indexdb/WIFI-Temperature-Humidity-Sensor/pcb/BOM_ESP8266 温湿度传感器_超低功耗_PCB2_1_2025-12-18.xlsx

No. | Quantity | Comment | Designator | Footprint | Value | Manufacturer Part | Manufacturer | Supplier Part | Supplier
1 | 1 | BH-18650-B1BA002 | BT1 | BATTERY-SMD_18650-1S-L77.1-W20.7-1 |  | BH-18650-B1BA002 | MYOUNG(美阳) | C2988620 | LCSC
2 | 1 | 10uF | C1 | C0805 |  | C0805X105K101T | HEC | C105952 | LCSC
3 | 1 | 1uF | C2 | C0805 |  | C0805X105K101T | HEC | C105952 | LCSC
4 | 1 | 0.1uf | C5 | C0805 | 4.7nF | TCC0805X7R472K501FT | CCTC(三环) | C282767 | LCSC
5 | 1 | 10uf | C6 | C0805 | 10uf
6 | 1 | 2.4GHz | MK1 | WIRELM-SMD_22P-L24.0-W16.0-P2.00_WT32C3-S5 | 2.4GHz | ESP-12F | DOIT(四博智联) | C19949064 | LCSC
7 | 1 | AO3401 | Q1 | SOT-23-3_L2.9-W1.4-P1.90-LS2.6-BR |  | AO3401 | TWGMC(台湾迪嘉) | C727156 | LCSC
8 | 5 | 10K | R1,R4,R5,R7,R8 | R0805 |  | MCR10EZPF1000 | ROHM Semicon | C162019 | LCSC
9 | 1 | 30K | R3 | R0805 | 30K
10 | 1 | 2kΩ | R6 | R0805 | 2kΩ | 0805W8F2001T5E | UNI-ROYAL(厚声) | C17604 | LCSC
11 | 1 | 10K | R9 | R0805 | 10K
12 | 2 | 10kΩ | R10,R11 | R0805 |  | AECR0603F10K0K9 | ResistorToday | C328335 | LCSC
13 | 1 | 1K | R12 | R0805 |  | SCR0805J1K | VO(翔胜) | C3017842 | LCSC
14 | 1 | 54.9K | R13 | R0805 | 54.9K
15 | 1 | 196.0K | R14 | R0805 | 196.0K
16 | 3 | 100K | R16,R17,R18 | R0805 | 100K
17 | 1 | SIP4-CON4排针 | S1 | HDR-TH_4P-P2.54-V-M-3 |  | SIP4-CON4排针 |  | C9900002129 | LCSC
18 | 1 | TSA343G00-250J2 | SW1 | SW-SMD_L4.0-W2.9-LS5.0 |  | TSA343G00-250J2 | BRIGHT(博瑞泰) | C354946 | LCSC
19 | 1 | HDC2080 | U1 | WSON-6_L3.0-W3.0-P1.00-TL-EP |  | HDC2080DMBR | TI(德州仪器) | C918141 | LCSC
20 | 1 | IP3012A | U2 | SOT-23-5_L3.0-W1.7-P0.95-LS2.8-BL |  | IP3012A | INJOINIC(英集芯) | C605435 | LCSC
21 | 1 | HT-7333-2 | U3 | SOT-89-3_L4.5-W2.5-P1.50-LS4.2-BR |  | HT-7333-2 |  | C9900012669 | LCSC
22 | 1 | TPL5110DDCR | U4 | TSOT-23-6_L2.9-W1.6-P0.95-LS2.8-BR |  | TPL5110DDCR | TI(德州仪器) | C2651358 | LCSC
