indexdb/WIFI-Temperature-Humidity-Sensor/pcb/SCH_Schematic2_1_2025-12-18.pdf

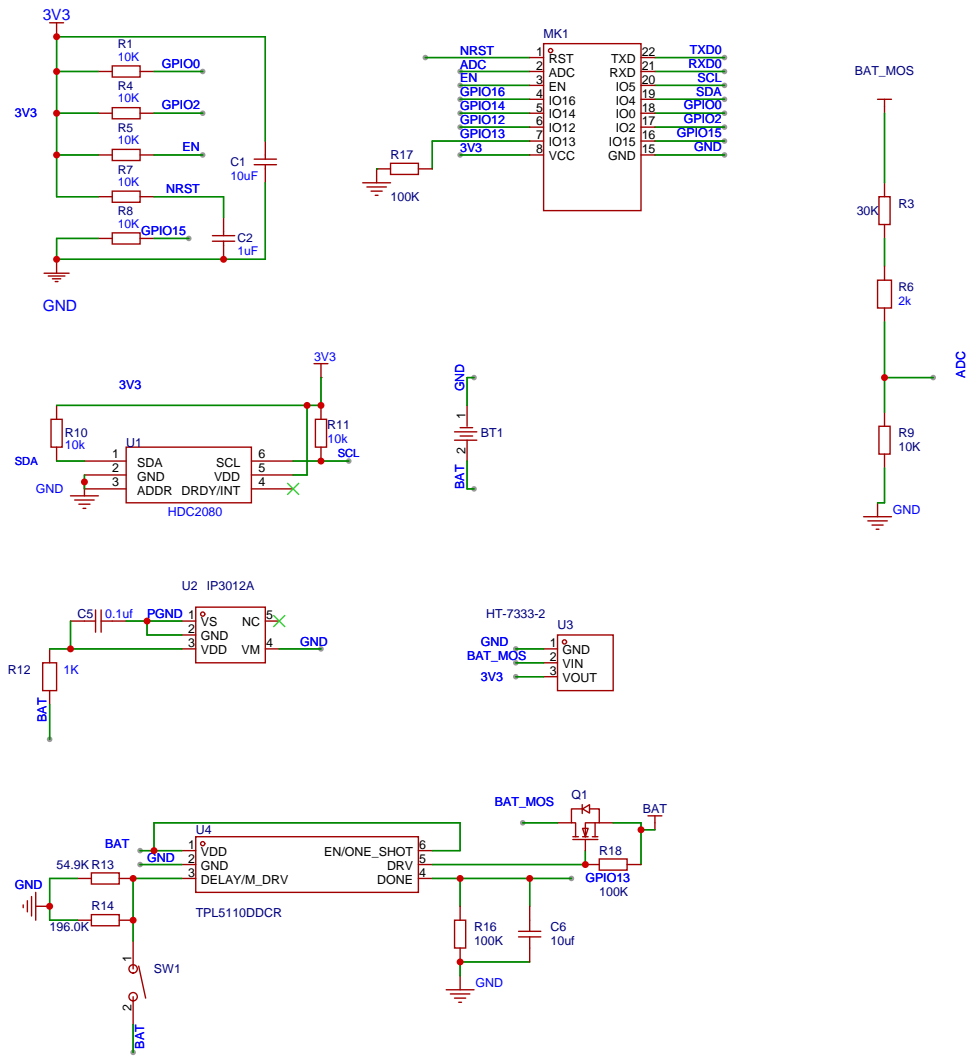
[picture p4: page 1]
